VarunAPatil/sra-board-hardware-design/datasheets/README.md

# 2027 board datasheets

| Part | Local document | Publisher/reference |
| --- | --- | --- |
| TPS54202 | [TPS54202.pdf](TPS54202.pdf) | [Texas Instruments](https://www.ti.com/lit/ds/symlink/tps54202.pdf) |
| SS14 | [SS14.pdf](SS14.pdf) | Schottky diode datasheet |
| SS34 | [SS34.pdf](SS34.pdf) | Schottky diode datasheet |
| SS54 | [SS54.pdf](SS54.pdf) | SS54 through SS520 family datasheet |
| MAX7219 | Online: [MAX7219/MAX7221 datasheet](https://www.analog.com/media/en/technical-documentation/data-sheets/MAX7219-MAX7221.pdf) | Analog Devices |
| SPDT slide switch | [SPDT-slide-switch.pdf](SPDT-slide-switch.pdf) | [Sunrom document 460](https://www.sunrom.com/download/460.pdf), as requested |
| MPU-6050 | Online: [MPU-6000/MPU-6050 product specification](https://product.tdk.com/system/files/dam/doc/product/sensor/mortion-inertial/imu/data_sheet/mpu-6000-datasheet1.pdf) | TDK InvenSense |
| ESP32-S3-WROOM-1 | [ESP32-S3-WROOM-1.pdf](ESP32-S3-WROOM-1.pdf) | Espressif |
| AMS1117-3.3 | [AMS1117-3.3.pdf](AMS1117-3.3.pdf) | AMS1117 family |
| TB6612FNG | [TB6612FNG.pdf](TB6612FNG.pdf) | Toshiba |
| TCRT5000 | [TCRT5000.pdf](TCRT5000.pdf) | Vishay |
| AO3401A | [AO3401A.pdf](AO3401A.pdf) | AOSMD |
