VarunAPatil/sra-board-hardware-design/gerbers/README.md

# 2027 fabrication exports

| Board | ZIP | Uncompressed plots |
| --- | --- | --- |
| SRA controller | [sra_board_2027.zip](sra_board_2027.zip) | [sra_board_2027/](sra_board_2027/) |
| Line sensor array | [lsa_board_2027.zip](lsa_board_2027.zip) | [lsa_board_2027/](lsa_board_2027/) |
