VarunAPatil/sra-board-hardware-design/documentation/assets/led_matrix_schematic_detail.png

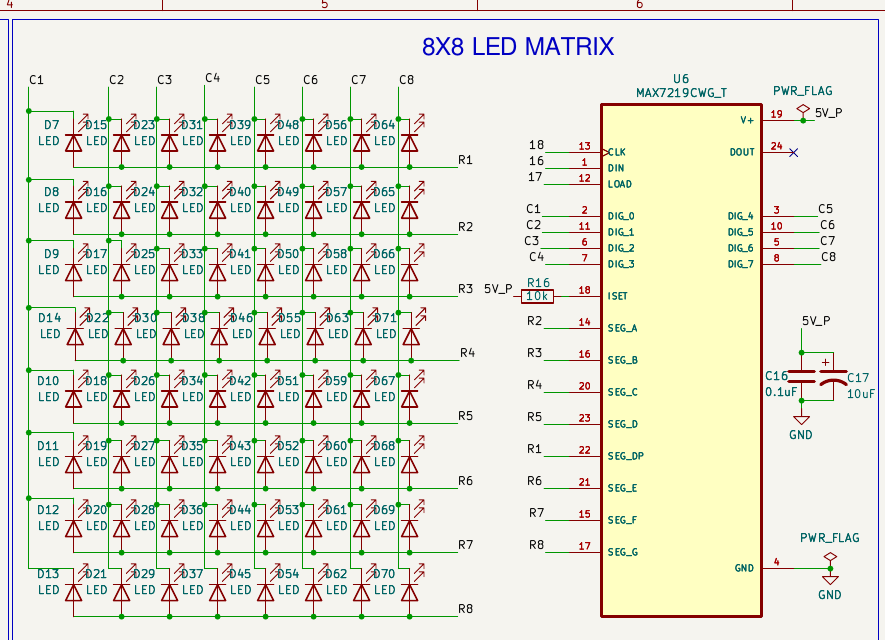
documentation/assets/led_matrix_schematic_detail.png
