VarunAPatil/sra-board-hardware-design/documentation/assets/lsa_interface_schematic_detail.png

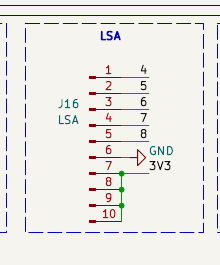
documentation/assets/lsa_interface_schematic_detail.png
