VarunAPatil/sra-board-hardware-design/documentation/assets/lsa_schematic_2027.png

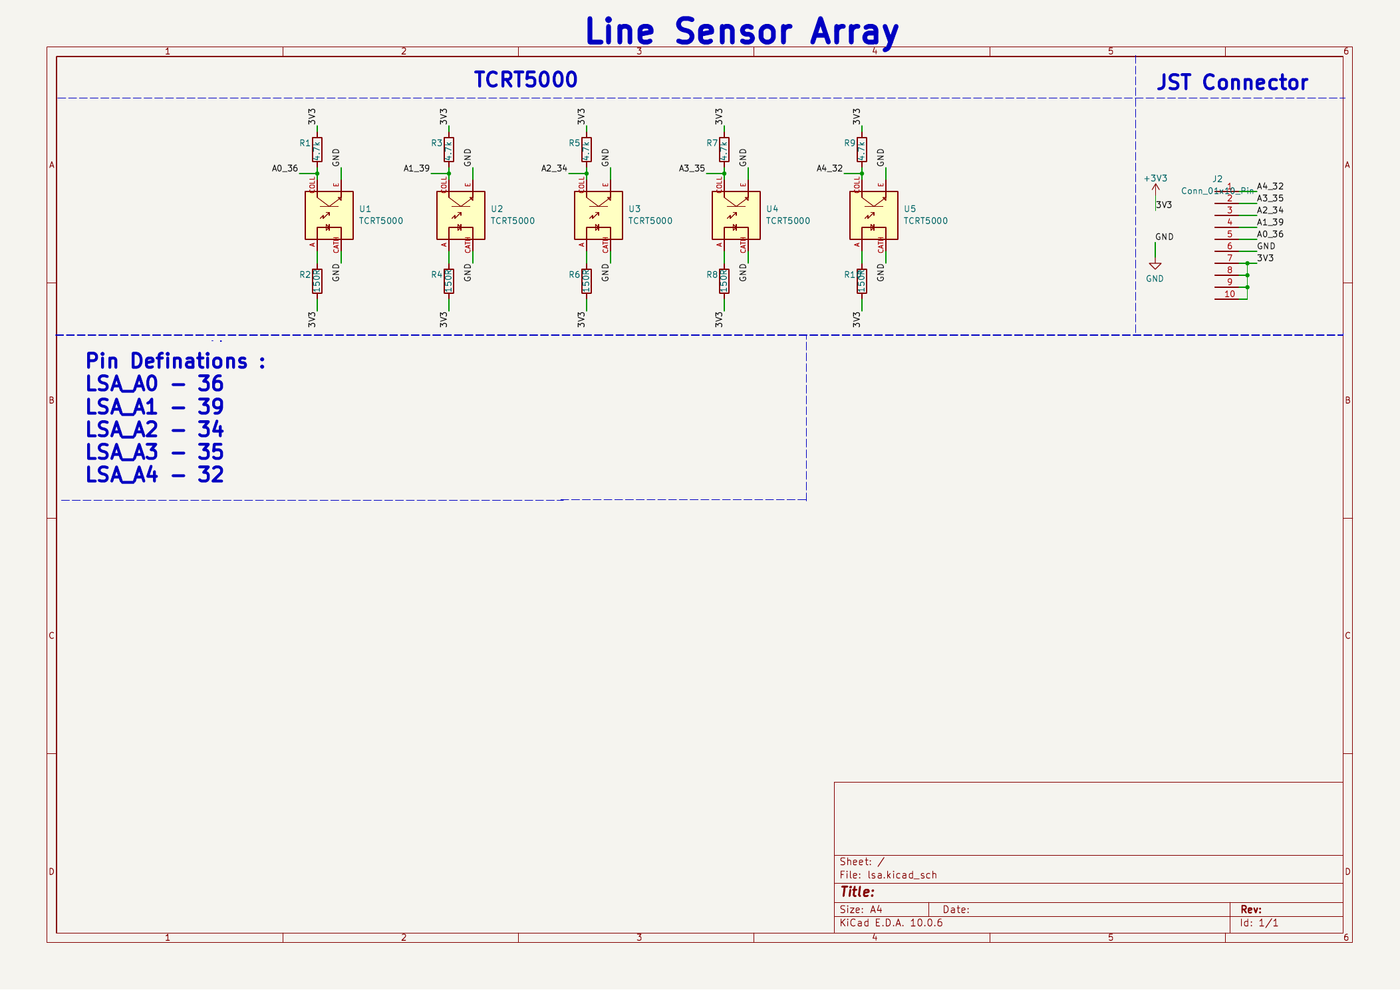
documentation/assets/lsa_schematic_2027.png
