VarunAPatil/sra-board-hardware-design/documentation/assets/motor_driver_schematic_detail.png

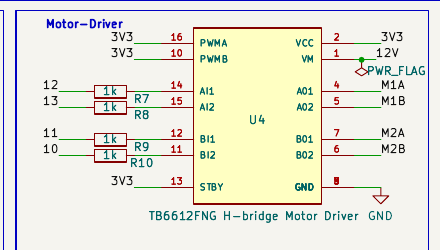
documentation/assets/motor_driver_schematic_detail.png
