VarunAPatil/sra-board-hardware-design/documentation/assets/mpu6050_schematic_detail.png

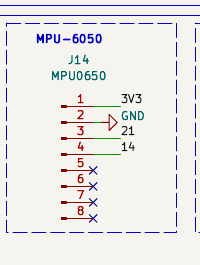
documentation/assets/mpu6050_schematic_detail.png
