VarunAPatil/sra-board-hardware-design/documentation/assets/oled_connector_schematic_detail.png

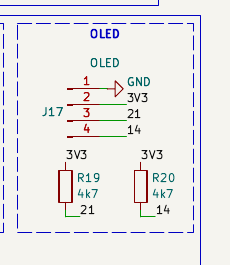
documentation/assets/oled_connector_schematic_detail.png
