VarunAPatil/sra-board-hardware-design/documentation/assets/power_stage_schematic_detail.png

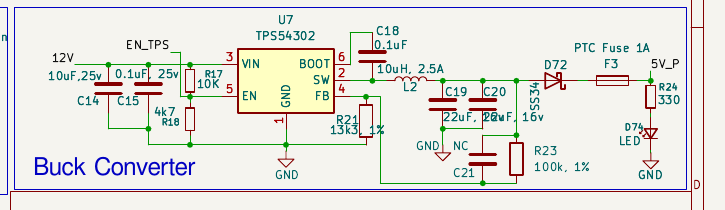
documentation/assets/power_stage_schematic_detail.png
