VarunAPatil/sra-board-hardware-design/documentation/assets/usb_c_schematic_detail.png

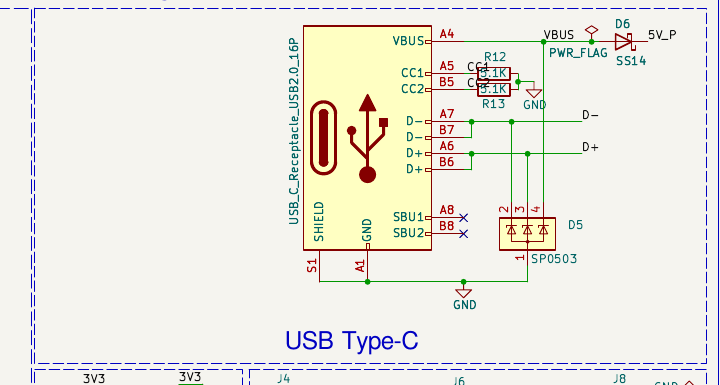
documentation/assets/usb_c_schematic_detail.png
