VarunAPatil/sra-board-hardware-design/lsa_board_2027/bom/lsa_board_2027.csv

Refs | Value | Footprint | Qty | DNP
J2 | Conn_01x10_Pin | Connector_FFC-FPC:JUSHUO_AFA07-S10FCA-00_1x10-1MP_P1.0mm_Horizontal | 1
R1 | 4.7k | Resistor_SMD:R_1206_3216Metric_Pad1.30x1.75mm_HandSolder | 1
R2 | 150R | Resistor_SMD:R_1206_3216Metric_Pad1.30x1.75mm_HandSolder | 1
R3 | 4.7k | Resistor_SMD:R_1206_3216Metric_Pad1.30x1.75mm_HandSolder | 1
R4 | 150R | Resistor_SMD:R_1206_3216Metric_Pad1.30x1.75mm_HandSolder | 1
R5 | 4.7k | Resistor_SMD:R_1206_3216Metric_Pad1.30x1.75mm_HandSolder | 1
R6 | 150R | Resistor_SMD:R_1206_3216Metric_Pad1.30x1.75mm_HandSolder | 1
R7 | 4.7k | Resistor_SMD:R_1206_3216Metric_Pad1.30x1.75mm_HandSolder | 1
R8 | 150R | Resistor_SMD:R_1206_3216Metric_Pad1.30x1.75mm_HandSolder | 1
R9 | 4.7k | Resistor_SMD:R_1206_3216Metric_Pad1.30x1.75mm_HandSolder | 1
R10 | 150R | Resistor_SMD:R_1206_3216Metric_Pad1.30x1.75mm_HandSolder | 1
U1 | TCRT5000 | TCRT5000:OPTO_TCRT5000 | 1
U2 | TCRT5000 | TCRT5000:OPTO_TCRT5000 | 1
U3 | TCRT5000 | TCRT5000:OPTO_TCRT5000 | 1
U4 | TCRT5000 | TCRT5000:OPTO_TCRT5000 | 1
U5 | TCRT5000 | TCRT5000:OPTO_TCRT5000 | 1
