VarunAPatil/sra-board-hardware-design/sra_board_2027/bom/sra_board_2027.csv

Refs | Value | Footprint | Qty | DNP
C5 | 0.1uF | Capacitor_SMD:C_0805_2012Metric | 1
C6 | 0.1uF | Capacitor_SMD:C_0805_2012Metric | 1
C7 | 0.1uF | Capacitor_SMD:C_0805_2012Metric | 1
C8 | 0.1uF | Capacitor_SMD:C_1206_3216Metric | 1
C9 | 0.1uF | Capacitor_SMD:C_1206_3216Metric | 1
C10 | 0.1uF, 16v | Capacitor_SMD:C_0805_2012Metric | 1
C11 | 10uF, 16v | Capacitor_SMD:C_0805_2012Metric | 1
C12 | 0.1uF | Capacitor_SMD:C_0805_2012Metric | 1
C13 | 22uF | Capacitor_SMD:C_0805_2012Metric | 1
C14 | 10uF,25v | Capacitor_SMD:C_1206_3216Metric | 1
C15 | 0.1uF, 25v | Capacitor_SMD:C_1206_3216Metric | 1
C16 | 0.1uF | Capacitor_SMD:C_0805_2012Metric | 1
C17 | 10uF | Capacitor_SMD:C_0805_2012Metric | 1
C18 | 0.1uF | Capacitor_SMD:C_0805_2012Metric | 1
C19 | 22uF, 16v | Capacitor_SMD:C_1206_3216Metric | 1
C20 | 22uF, 16v | Capacitor_SMD:C_1206_3216Metric | 1
C22 | 10uF | Capacitor_SMD:C_0805_2012Metric | 1
D5 | SP0503 | Package_TO_SOT_SMD:SOT-143 | 1
D6 | SS14 | Diode_SMD:D_SMA | 1
D7 | LED | LED_SMD:LED_0805_2012Metric | 1
D8 | LED | LED_SMD:LED_0805_2012Metric | 1
D9 | LED | LED_SMD:LED_0805_2012Metric | 1
D10 | LED | LED_SMD:LED_0805_2012Metric | 1
D11 | LED | LED_SMD:LED_0805_2012Metric | 1
D12 | LED | LED_SMD:LED_0805_2012Metric | 1
D13 | LED | LED_SMD:LED_0805_2012Metric | 1
D14 | LED | LED_SMD:LED_0805_2012Metric | 1
D15 | LED | LED_SMD:LED_0805_2012Metric | 1
D16 | LED | LED_SMD:LED_0805_2012Metric | 1
D17 | LED | LED_SMD:LED_0805_2012Metric | 1
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
Q7 | ZXMP4A16GTA | Package_TO_SOT_SMD:SOT-223 | 1
R1 | 33k | Resistor_SMD:R_0805_2012Metric | 1
R2 | 10k | Resistor_SMD:R_0805_2012Metric | 1
R7 | 1k | Resistor_SMD:R_0805_2012Metric | 1
R8 | 1k | Resistor_SMD:R_0805_2012Metric | 1
R9 | 1k | Resistor_SMD:R_0805_2012Metric | 1
R10 | 1k | Resistor_SMD:R_0805_2012Metric | 1
R11 | 10K | Resistor_SMD:R_0805_2012Metric | 1
R12 | 5.1K | Resistor_SMD:R_0805_2012Metric | 1
R13 | 5.1K | Resistor_SMD:R_0805_2012Metric | 1
R14 | 100K | Resistor_SMD:R_0805_2012Metric | 1
R15 | 330 | Resistor_SMD:R_0805_2012Metric | 1
R16 | 10k | Resistor_SMD:R_0805_2012Metric | 1
R17 | 10K | Resistor_SMD:R_0805_2012Metric | 1
R18 | 4k7 | Resistor_SMD:R_0805_2012Metric | 1
R19 | 4k7 | Resistor_SMD:R_0805_2012Metric | 1
R20 | 4k7 | Resistor_SMD:R_0805_2012Metric | 1
R21 | 13k3, 1% | Resistor_SMD:R_0805_2012Metric | 1
R22 | 10K | Resistor_SMD:R_0805_2012Metric | 1
R23 | 100k, 1% | Resistor_SMD:R_0805_2012Metric | 1
R24 | 330 | Resistor_SMD:R_0805_2012Metric | 1
R25 | 330 | Resistor_SMD:R_0805_2012Metric | 1
SW1 | SW_0 | Button_Switch_SMD:SW_Push_SPST_NO_Alps_SKRK | 1
SW2 | SW_EN | Button_Switch_SMD:SW_Push_SPST_NO_Alps_SKRK | 1
SW3 | SMD Slide switch | Button_Switch_SMD:SW_SPDT_Shouhan_MSK12C02 | 1
SW4 | SMD Slide switch | Button_Switch_SMD:SW_SPDT_Shouhan_MSK12C02 | 1
TP1 | TestPoint_2Pole | footprints:test_point | 1
TP2 | TestPoint | footprints:test_point | 1
TP3 | TestPoint | footprints:test_point | 1
TP5 | TestPoint | footprints:test_point | 1
U2 | ESP32-S3-WROOM-1 | RF_Module:ESP32-S3-WROOM-1 | 1
U4 | TB6612FNG H-bridge Motor Driver | footprints:MODULE_ROB-14450 | 1
U5 | AMS1117-3.3 | Package_TO_SOT_SMD:SOT-223-3_TabPin2 | 1
U6 | MAX7219CWG_T | footprints:SOIC24 | 1
U7 | TPS54302 | Package_TO_SOT_SMD:SOT-23-6 | 1
