VarunAPatil/sra-board-hardware-design/3d_models/components/MPU6050Module.step

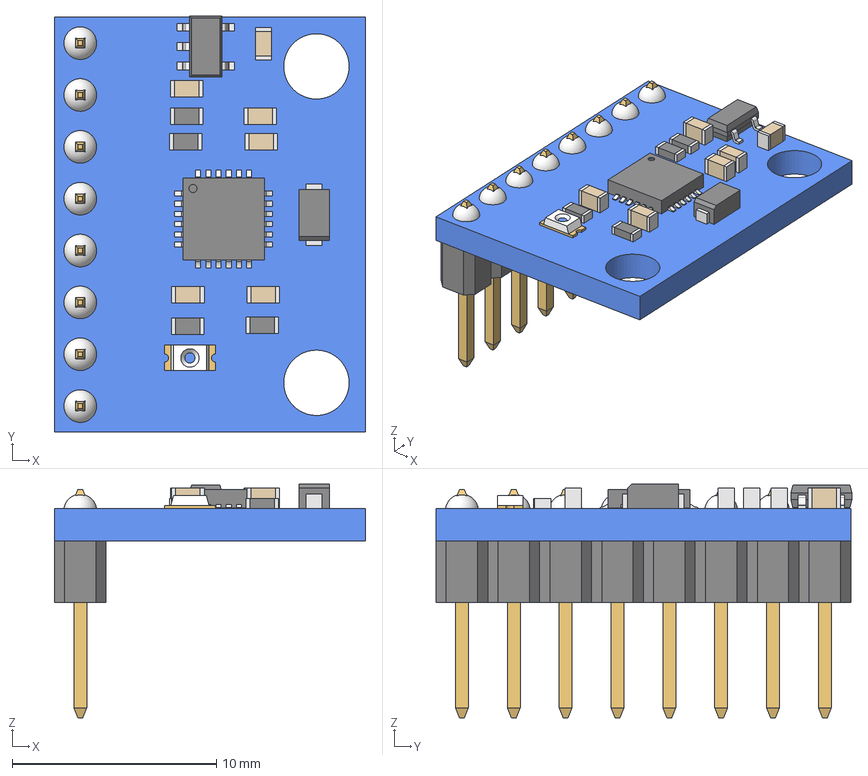
[picture p14: CAD file, 2026-11-04]
3d_models/components/MPU6050Module.step
15.3 x 20.4 x 11.5 mm
Board_001
SOT25_001
0603 Capacitor_001
0603 Capacitor_002
0603 Capacitor_003
0603 Capacitor_004
0603 Capacitor_005
0603 Capacitor_006
0603 Resistor_001
0603 Resistor_002
0603 Resistor_003
0603 Resistor_004
SM LED_001
Diode 2_001
24 QFN_001
1x8 Male Header_001
