VarunAPatil/sra-board-hardware-design/3d_models/sra_board_2027.step

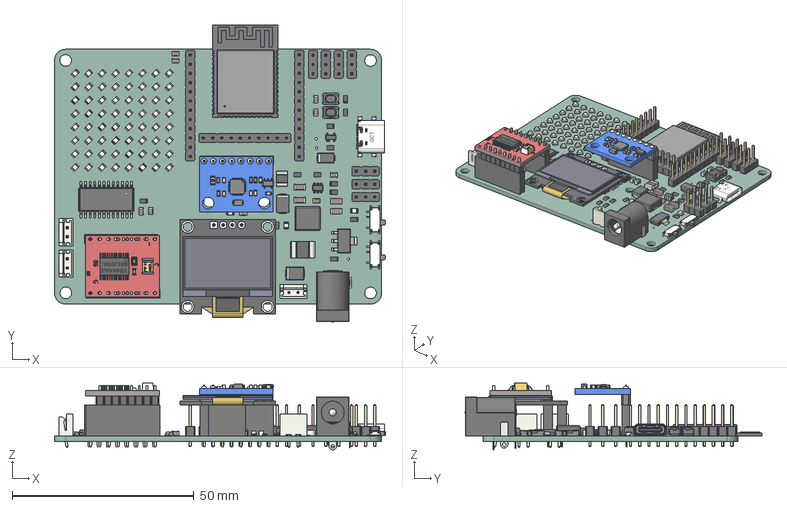
[picture p15: CAD file, 2026-11-04]
3d_models/sra_board_2027.step
91.1 x 81.7 x 18.4 mm
C_0805_2012Metric x 12
USB4110-GF-A_revB(1) MF
R_0805_2012Metric x 21
LED_0805_2012Metric x 67
PinHeader_1x03_P254mm_Vertical x 7
JST_B2B_EH_A x 3
8x1 male header pins v2 x 2
PinSocket_1x08_P2.54mm_Vertical x 3
ESP32-S3-WROOM-1
C_1206_3216Metric x 6
Board_001
SOT25_001
0603 Capacitor_001
0603 Capacitor_002
0603 Capacitor_003
0603 Capacitor_004
0603 Capacitor_005
0603 Capacitor_006
0603 Resistor_001
0603 Resistor_002
0603 Resistor_003
0603 Resistor_004
SM LED_001
Diode 2_001
24 QFN_001
1x8 Male Header_001
D_SMA
SOT-23-6
PinHeader_1x12_P254mm_Vertical x 2
MSK12C02 x 2
SOT-223 x 2
Fuse_1210_3225Metric x 2
a71ba5e0-8551-11ed-a139-00155d22e2d7_part
a71ba716-8551-11ed-a139-00155d22e2d7_part
a71ba78e-8551-11ed-a139-00155d22e2d7_part
D_SMB x 2
PinSocket_1x04_P2.54mm_Vertical
Body - PCB
Body - Back Panel
Body - Adhesive Pad
Body - Front Panel
Body - Flex Connector Bend
Body - Flex Connector Terminals
Body - Black Tape
Body - Protective Foil
Body - Screen Border
Extrude - Annular Rings
SW_SPST_PTS810 x 2
HTSSOP-24-1EP_4.4x7.8mm_P0.65mm_EP3.4x7.8mm_Mask2.4x4.68mm
PinHeader_1x10_P254mm_Vertical
SOT-143
BarrelJack_Horizontal
sra_board_PCB
