VarunAPatil/sra-board-hardware-design/3d_models/components/TCRT5000.step

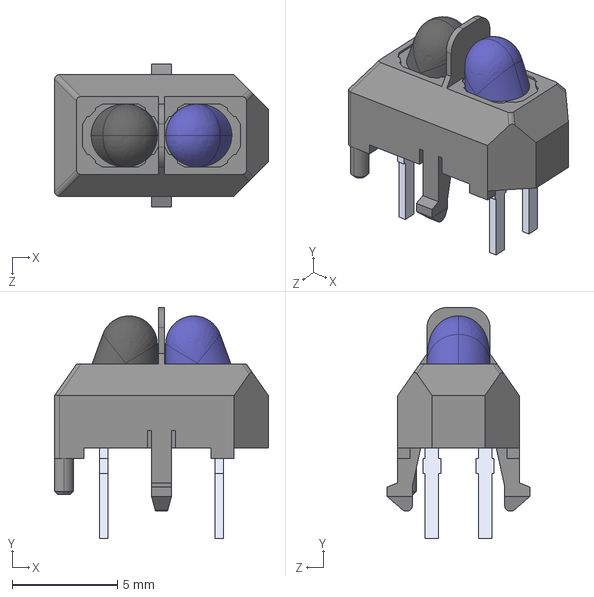
[picture p16: CAD file, 2026-11-04]
3d_models/components/TCRT5000.step
10.2 x 11.0 x 6.80 mm
