VarunAPatil/sra-board-hardware-design/3d_models/lsa_board_2027.step

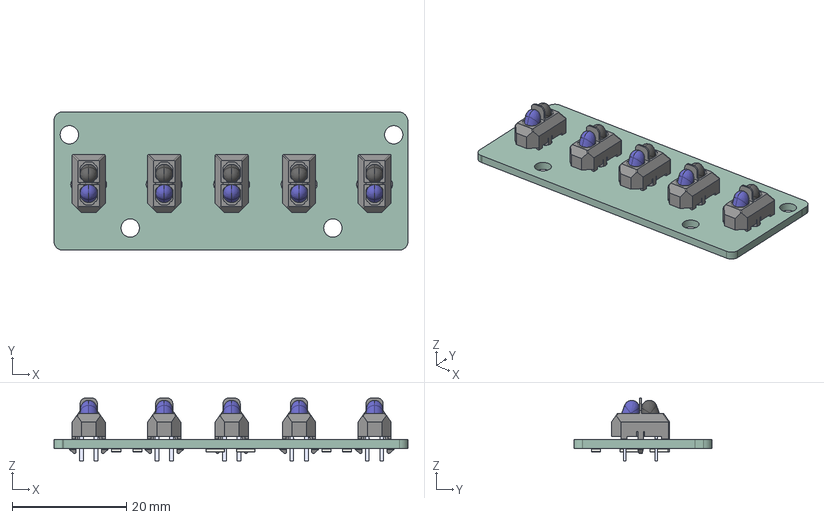
[picture p17: CAD file, 2026-11-04]
3d_models/lsa_board_2027.step
61.9 x 24.2 x 11.0 mm
TCRT5000 x 5
R_1206_3216Metric x 10
lsa_PCB
