VarunAPatil/sra-board-hardware-design/3d_models/components/MotorDriver.step

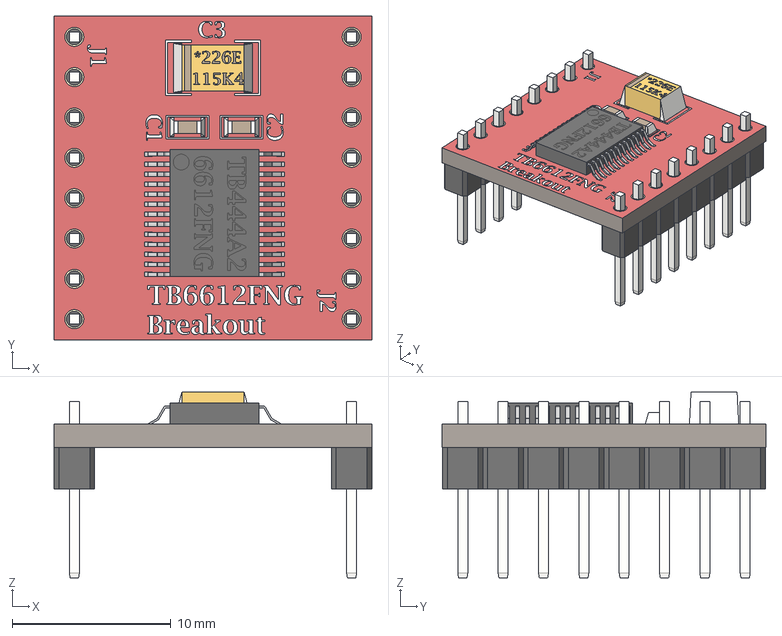
[picture p18: CAD file, 2026-11-04]
3d_models/components/MotorDriver.step
20.0 x 20.4 x 11.7 mm
8x1 male header pins x 2
