VarunAPatil/sra-board-hardware-design/3d_models/components/spdt-switch.stp

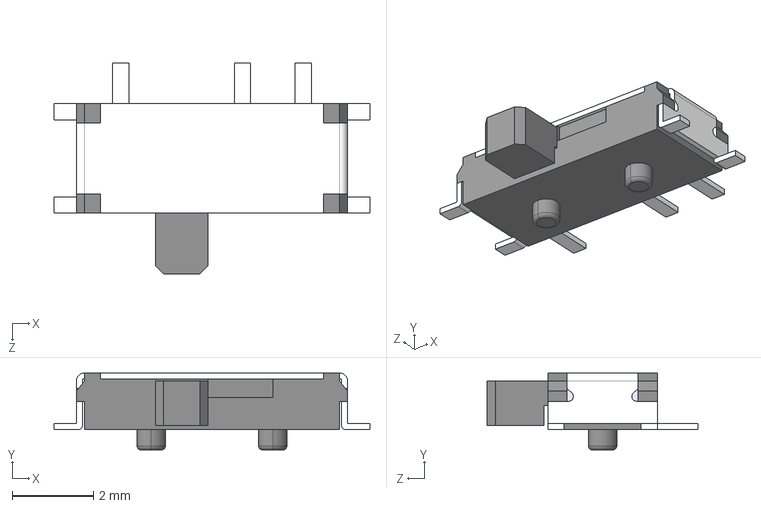
[picture p19: CAD file, 2026-11-04]
3d_models/components/spdt-switch.stp
7.80 x 1.90 x 5.20 mm
