VarunAPatil/sra-board-hardware-design/3d_models/components/MAX7219.step

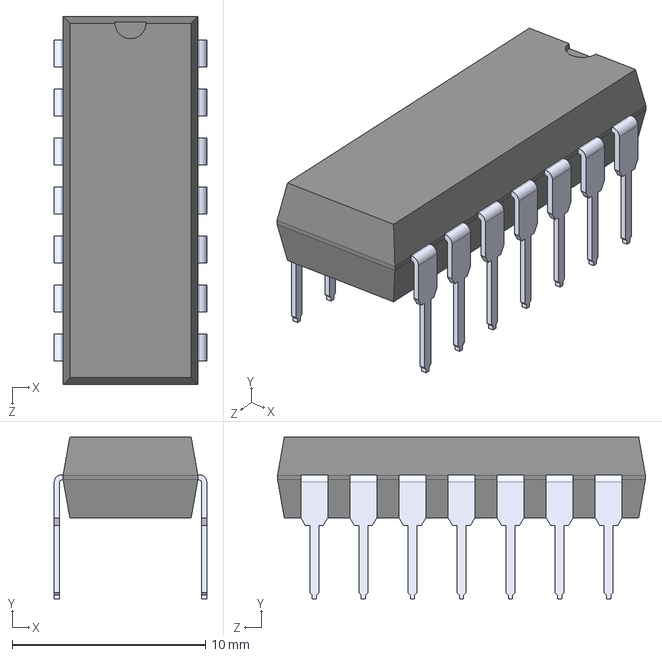
[picture p20: CAD file, 2026-11-04]
3d_models/components/MAX7219.step
7.90 x 8.38 x 19.1 mm
