VarunAPatil/sra-board-hardware-design/3d_models/components/USB4110.STEP

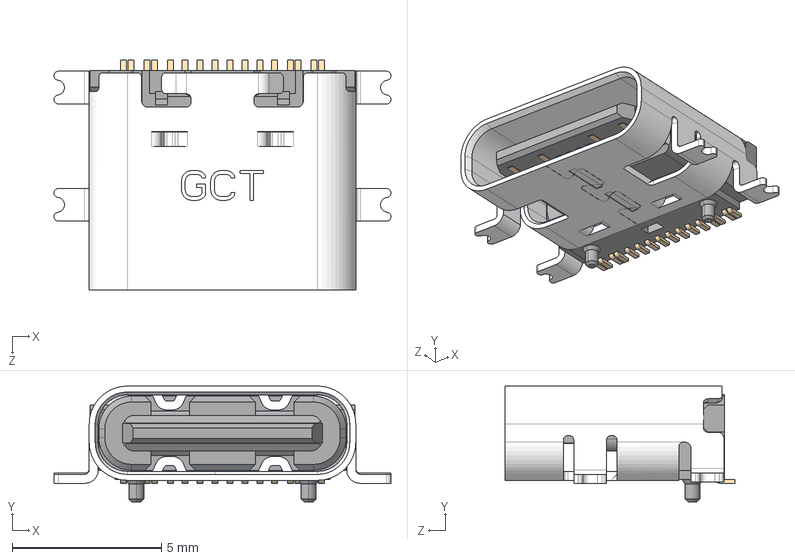
[picture p21: CAD file, 2026-11-04]
3d_models/components/USB4110.STEP
11.3 x 3.89 x 7.70 mm
