VarunAPatil/sra-board-hardware-design/3d_models/components/OLED.step

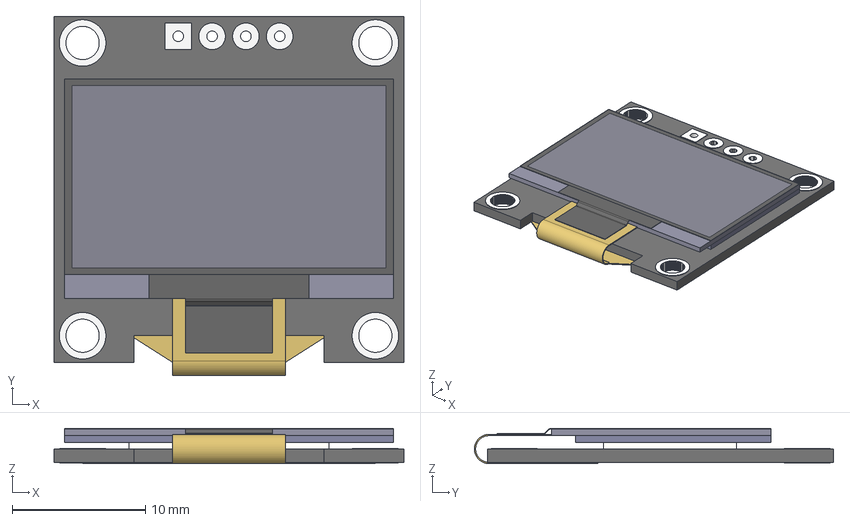
[picture p22: CAD file, 2026-11-04]
3d_models/components/OLED.step
26.3 x 27.0 x 2.65 mm
Body - PCB
Body - Back Panel
Body - Adhesive Pad
Body - Front Panel
Body - Flex Connector Bend
Body - Flex Connector Terminals
Body - Black Tape
Body - Protective Foil
Body - Screen Border
Extrude - Annular Rings
