VarunAPatil/sra-board-hardware-design/sra_board_2027/sra_board.kicad_pcb

## KiCad design sra_board_2027/sra_board.kicad_pcb (2026-11-04)

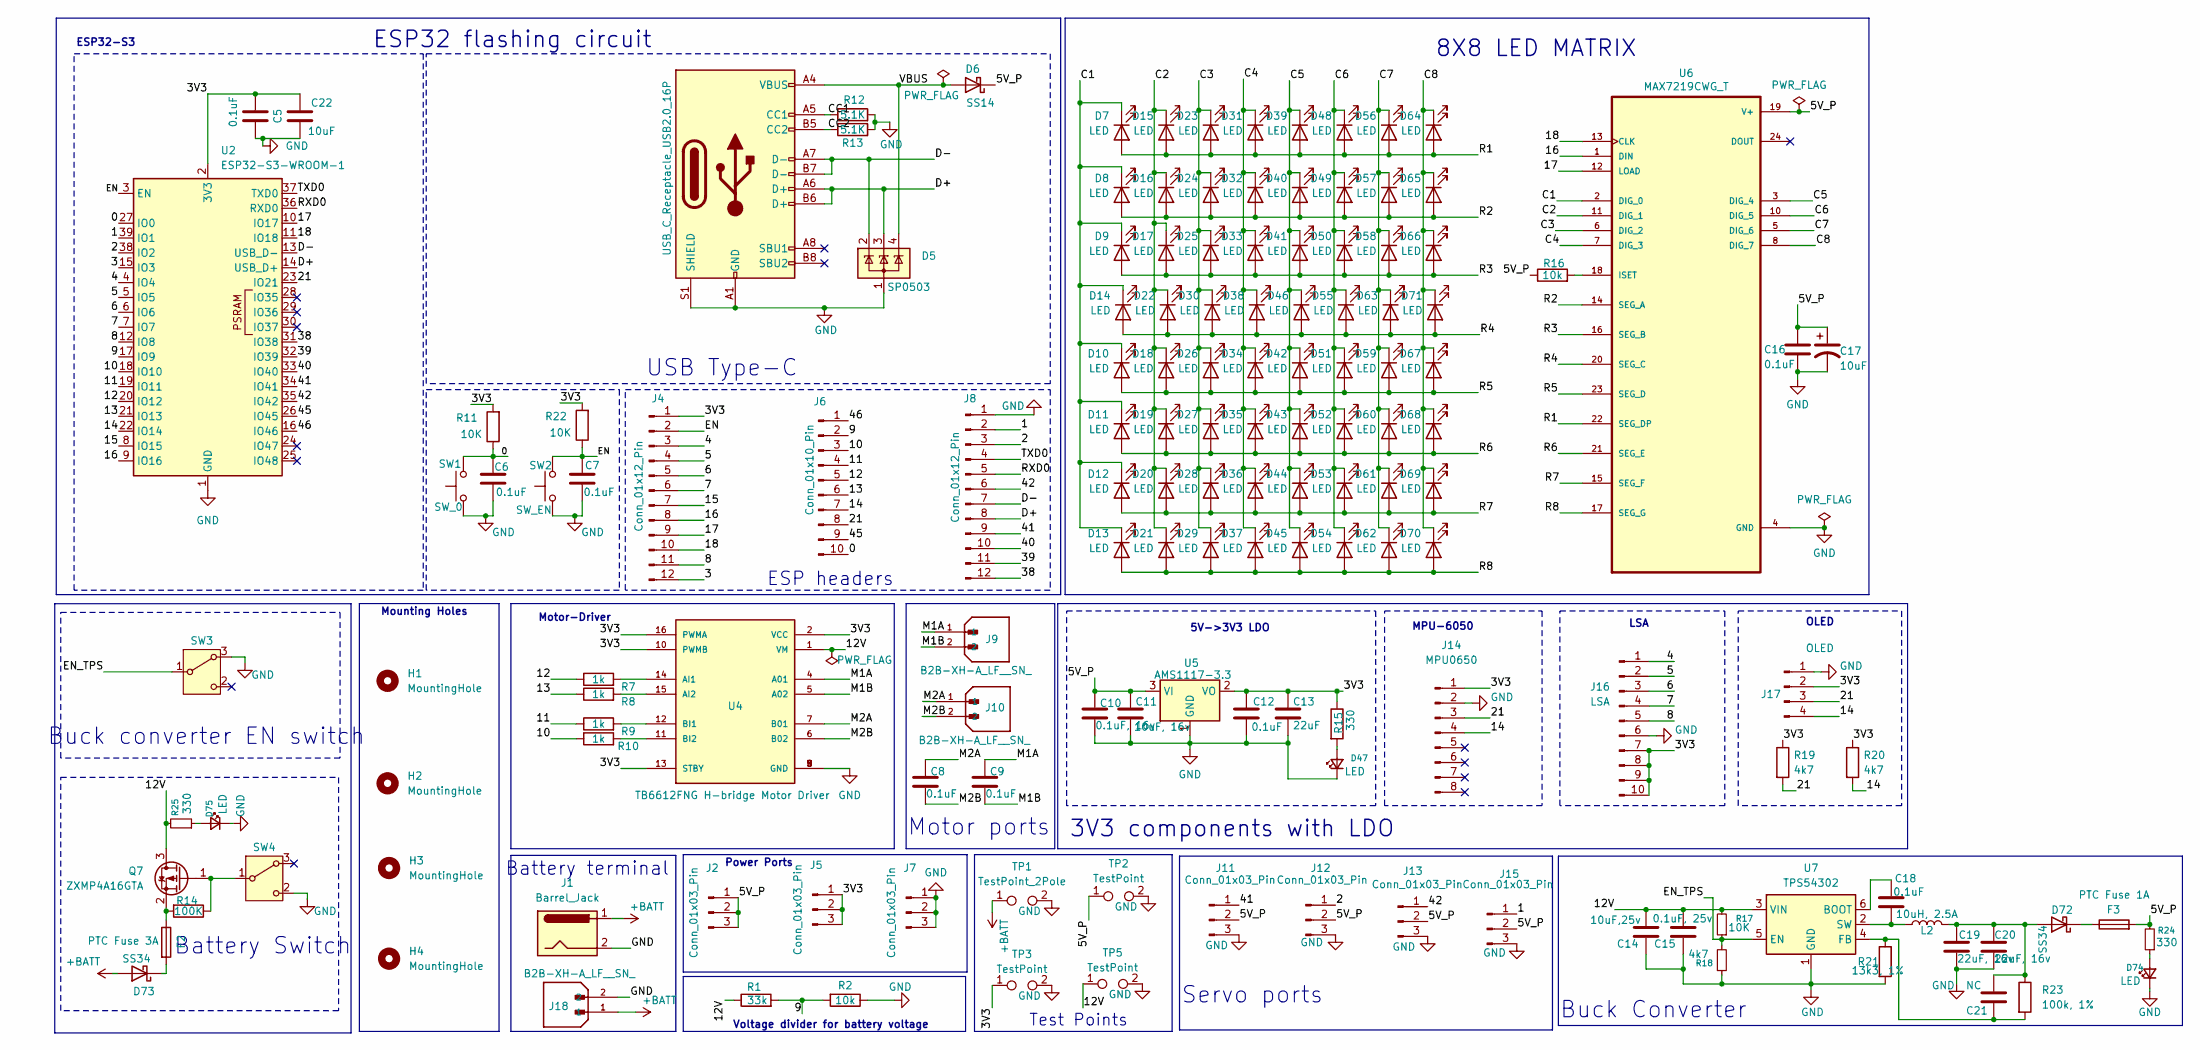
[picture p23: schematic sra_board.kicad_sch, SRA BOARD 2026-27]

Parts:
C5, C6, C7, C12, C16, C18: 0.1uF; C_0805_2012Metric
C8, C9: 0.1uF; C_1206_3216Metric
C10: 0.1uF, 16v; C_0805_2012Metric
C11: 10uF, 16v; C_0805_2012Metric
C13: 22uF; C_0805_2012Metric
C14: 10uF,25v; C_1206_3216Metric
C15: 0.1uF, 25v; C_1206_3216Metric
C17, C22: 10uF; C_0805_2012Metric
C19, C20: 22uF, 16v; C_1206_3216Metric
C21: NC; C_0805_2012Metric
D5: SP0503; SOT-143
D6: SS14; D_SMA
D7, D8, D9, D10, D11, D12, D13, D14, D15, D16, D17, D18, D19, D20, D21, D22, D23, D24, D25, D26, D27, D28, D29, D30, D31, D32, D33, D34, D35, D36, D37, D38, D39, D40, D41, D42, D43, D44, D45, D46, D47, D48, D49, D50, D51, D52, D53, D54, D55, D56, D57, D58, D59, D60, D61, D62, D63, D64, D65, D66, D67, D68, D69, D70, D71, D74, D75: LED; LED_0805_2012Metric
D72, D73: SS34; D_SMB
F2: PTC Fuse 3A; Fuse_2920_7451Metric
F3: PTC Fuse 1A; Fuse_1812_4532Metric
H1, H2, H3, H4: MountingHole; MountingHole_3.2mm_M3_DIN965_Pad_TopOnly
J1: Barrel_Jack; BarrelJack_Wuerth_6941xx301002
J2, J5, J7, J11, J12, J13, J15: Conn_01x03_Pin; PinHeader_1x03_P2.54mm_Vertical
J3: USB_C_Receptacle_USB2.0_16P; USB_C_Receptacle_GCT_USB4110
J4, J8: Conn_01x12_Pin; PinHeader_1x12_P2.54mm_Vertical
J6: Conn_01x10_Pin; PinHeader_1x10_P2.54mm_Vertical
J9, J10, J18: B2B-XH-A_LF__SN_; JST_EH_B2B-EH-A_1x02_P2.50mm_Vertical; PARTREV N/A
J14: MPU0650; PinSocket_1x08_P2.54mm_Vertical
J16: LSA; JUSHUO_AFA07-S10FCA-00_1x10-1MP_P1.0mm_Horizontal
J17: OLED; PinSocket_1x04_P2.54mm_Vertical
L2: 10uH, 2.5A; L_Sunlord_MWSA0603S
Q7: ZXMP4A16GTA; SOT-223
R1: 33k; R_0805_2012Metric
R2, R16: 10k; R_0805_2012Metric
R7, R8, R9, R10: 1k; R_0805_2012Metric
R11, R17, R22: 10K; R_0805_2012Metric
R12, R13: 5.1K; R_0805_2012Metric
R14: 100K; R_0805_2012Metric
R15, R24, R25: 330; R_0805_2012Metric
R18, R19, R20: 4k7; R_0805_2012Metric
R21: 13k3, 1%; R_0805_2012Metric
R23: 100k, 1%; R_0805_2012Metric
SW1: SW_0; SW_Push_SPST_NO_Alps_SKRK
SW2: SW_EN; SW_Push_SPST_NO_Alps_SKRK
SW3, SW4: SMD Slide switch; SW_SPDT_Shouhan_MSK12C02
TP1: TestPoint_2Pole; test_point
TP2, TP3, TP5: TestPoint; test_point
U2: ESP32-S3-WROOM-1
U4: TB6612FNG H-bridge Motor Driver; MODULE_ROB-14450
U5: AMS1117-3.3; SOT-223-3_TabPin2
U6: MAX7219CWG_T; SOIC24
U7: TPS54302; SOT-23-6

Connections:
+BATT: D73.2 (A), J1.1, J18.1, TP1.1 (1_1)
/0: C6.2, J6.10, R11.1, SW1.2, U2.27 (IO0)
/1: J8.2, J15.1, U2.39 (IO1)
/2: J8.3, J12.1, U2.38 (IO2)
/3: J4.12, U2.15 (IO3)
/3V3: C5.2, C12.1, C13.1, C22.1, J4.1, J5.1, J5.2, J5.3, J14.1, J16.7, J16.8, J16.9, J16.10, J17.2, R11.2, R15.1, R19.1, R20.1, R22.2, TP3.1 (1_1), U2.2 (3V3), U4.2 (VCC), U4.10 (PWMB), U4.13 (STBY), U4.16 (PWMA), U5.2 (VO)
/4: J4.3, J16.1, U2.4 (IO4)
/5: J4.4, J16.2, U2.5 (IO5)
/5V_P: C10.1, C11.1, C16.1, C17.1, D6.1 (K), F3.2, J2.1, J2.2, J2.3, J11.2, J12.2, J13.2, J15.2, R16.1, R24.2, TP2.1 (1_1), U5.3 (VI), U6.19 (V+)
/6: J4.5, J16.3, U2.6 (IO6)
/7: J4.6, J16.4, U2.7 (IO7)
/8: J4.11, J16.5, U2.12 (IO8)
/9: J6.2, R1.2, R2.2, U2.17 (IO9); also elsewhere on the board
/10: J6.3, R10.1, U2.18 (IO10)
/11: J6.4, R9.1, U2.19 (IO11)
/12: J6.5, R7.1, U2.20 (IO12)
/12V: C14.1, C15.1, Q7.3 (D), R1.1, R17.2, R25.2, TP5.1 (1_1), U4.1 (VM), U7.3 (VIN); also elsewhere on the board
/13: J6.6, R8.1, U2.21 (IO13)
/14: J6.7, J14.4, J17.4, R20.2, U2.22 (IO14)
/15: J4.7, U2.8 (IO15)
/16: J4.8, U2.9 (IO16), U6.1 (DIN)
/17: J4.9, U2.10 (IO17), U6.12 (LOAD)
/18: J4.10, U2.11 (IO18), U6.13 (CLK)
/21: J6.8, J14.3, J17.3, R19.2, U2.23 (IO21)
/38: J8.12, U2.31 (IO38)
/39: J8.11, U2.32 (IO39)
/40: J8.10, U2.33 (IO40)
/41: J8.9, J11.1, U2.34 (IO41)
/42: J8.6, J13.1, U2.35 (IO42)
/45: J6.9, U2.26 (IO45)
/46: J6.1, U2.16 (IO46)
/C1: D7.1 (K), D8.1 (K), D9.1 (K), D10.1 (K), D11.1 (K), D12.1 (K), D13.1 (K), D14.1 (K), U6.2 (DIG_0)
/C2: D15.1 (K), D16.1 (K), D17.1 (K), D18.1 (K), D19.1 (K), D20.1 (K), D21.1 (K), D22.1 (K), U6.11 (DIG_1)
/C3: D23.1 (K), D24.1 (K), D25.1 (K), D26.1 (K), D27.1 (K), D28.1 (K), D29.1 (K), D30.1 (K), U6.6 (DIG_2)
/C4: D31.1 (K), D32.1 (K), D33.1 (K), D34.1 (K), D35.1 (K), D36.1 (K), D37.1 (K), D38.1 (K), U6.7 (DIG_3)
/C5: D39.1 (K), D40.1 (K), D41.1 (K), D42.1 (K), D43.1 (K), D44.1 (K), D45.1 (K), D46.1 (K), U6.3 (DIG_4)
/C6: D48.1 (K), D49.1 (K), D50.1 (K), D51.1 (K), D52.1 (K), D53.1 (K), D54.1 (K), D55.1 (K), U6.10 (DIG_5)
/C7: D56.1 (K), D57.1 (K), D58.1 (K), D59.1 (K), D60.1 (K), D61.1 (K), D62.1 (K), D63.1 (K), U6.5 (DIG_6)
/C8: D64.1 (K), D65.1 (K), D66.1 (K), D67.1 (K), D68.1 (K), D69.1 (K), D70.1 (K), D71.1 (K), U6.8 (DIG_7)
/CC1: J3.A5 (CC1), R12.1; also elsewhere on the board
/CC2: J3.B5 (CC2), R13.1; also elsewhere on the board
/D+: D5.3 (K), J3.A6 (D+), J3.B6 (D+), J8.8, U2.14 (USB_D+); also elsewhere on the board
/D-: D5.2 (K), J3.A7 (D-), J3.B7 (D-), J8.7, U2.13 (USB_D-); also elsewhere on the board
/EN: C7.2, J4.2, R22.1, SW2.2, U2.3 (EN)
/EN_TPS: R17.1, R18.2, SW3.1 (B), U7.5 (EN)
/M1A: C9.1, J9.1, U4.4 (A01)
/M1B: C9.2, J9.2, U4.5 (A02)
/M2A: C8.1, J10.1, U4.7 (B01)
/M2B: C8.2, J10.2, U4.6 (B02)
/R1: D7.2 (A), D15.2 (A), D23.2 (A), D31.2 (A), D39.2 (A), D48.2 (A), D56.2 (A), D64.2 (A), U6.22 (SEG_DP)
/R2: D8.2 (A), D16.2 (A), D24.2 (A), D32.2 (A), D40.2 (A), D49.2 (A), D57.2 (A), D65.2 (A), U6.14 (SEG_A)
/R3: D9.2 (A), D17.2 (A), D25.2 (A), D33.2 (A), D41.2 (A), D50.2 (A), D58.2 (A), D66.2 (A), U6.16 (SEG_B)
/R4: D14.2 (A), D22.2 (A), D30.2 (A), D38.2 (A), D46.2 (A), D55.2 (A), D63.2 (A), D71.2 (A), U6.20 (SEG_C)
/R5: D10.2 (A), D18.2 (A), D26.2 (A), D34.2 (A), D42.2 (A), D51.2 (A), D59.2 (A), D67.2 (A), U6.23 (SEG_D)
/R6: D11.2 (A), D19.2 (A), D27.2 (A), D35.2 (A), D43.2 (A), D52.2 (A), D60.2 (A), D68.2 (A), U6.21 (SEG_E)
/R7: D12.2 (A), D20.2 (A), D28.2 (A), D36.2 (A), D44.2 (A), D53.2 (A), D61.2 (A), D69.2 (A), U6.15 (SEG_F)
/R8: D13.2 (A), D21.2 (A), D29.2 (A), D37.2 (A), D45.2 (A), D54.2 (A), D62.2 (A), D70.2 (A), U6.17 (SEG_G)
/RXD0: J8.5, U2.36 (RXD0)
/TXD0: J8.4, U2.37 (TXD0)
/VBUS: D5.4 (K), D6.2 (A), J3.A4 (VBUS), J3.A9 (VBUS), J3.B4 (VBUS), J3.B9 (VBUS); also elsewhere on the board
GND: C5.1, C6.1, C7.1, C10.2, C11.2, C12.2, C13.2, C14.2, C15.2, C16.2, C17.2, C19.2, C20.2, C22.2, D5.1 (A), D47.1 (K), D74.1 (K), D75.1 (K), J1.2, J3.A1 (GND), J3.A12 (GND), J3.B1 (GND), J3.B12 (GND), J3.S1 (SHIELD), J7.1, J7.2, J7.3, J8.1, J11.3, J12.3, J13.3, J14.2, J15.3, J16.6, J17.1, J18.2, R2.1, R12.2, R13.2, R18.1, R21.2, SW1.1 (1_1), SW2.1, SW3.3 (A), SW4.2 (C), TP1.2, TP2.2, TP3.2, TP5.2, U2.1 (GND), U2.40 (GND), U2.41 (GND), U4.3 (GND), U4.8 (GND), U4.9 (GND), U5.1 (GND), U6.4 (GND), U6.9 (GND), U7.1 (GND); also elsewhere on the board
unnamed: D47.2 (A), R15.2
unnamed: C19.1, C20.1, C21.1, D72.2 (A), L2.2, R23.1
unnamed: D72.1 (K), F3.1
unnamed: D73.1 (K), F2.2
unnamed: D74.2 (A), R24.1
unnamed: D75.2 (A), R25.1
unnamed: Q7.1 (G), R14.1, SW4.1 (B)
unnamed: F2.1, Q7.2 (S), R14.2
unnamed: R7.2, U4.14 (AI1)
unnamed: R8.2, U4.15 (AI2)
unnamed: R9.2, U4.12 (BI1)
unnamed: R10.2, U4.11 (BI2)
unnamed: R16.2, U6.18 (ISET)
unnamed: C18.1, U7.6 (BOOT)
unnamed: C21.2, R21.1, R23.2, U7.4 (FB)
unnamed: C18.2, L2.1, U7.2 (SW)

Notes on the sheet:
ESP32 flashing circuit
Power Ports
Motor-Driver
5V->3V3 LDO
ESP32-S3
Mounting Holes
Buck Converter
8X8 LED MATRIX
ESP headers
MPU-6050
Battery terminal
Voltage divider for battery voltage
LSA
OLED
3V3 components with LDO
Test Points
Battery Switch
USB Type-C
Servo ports
Buck converter EN switch
Motor ports

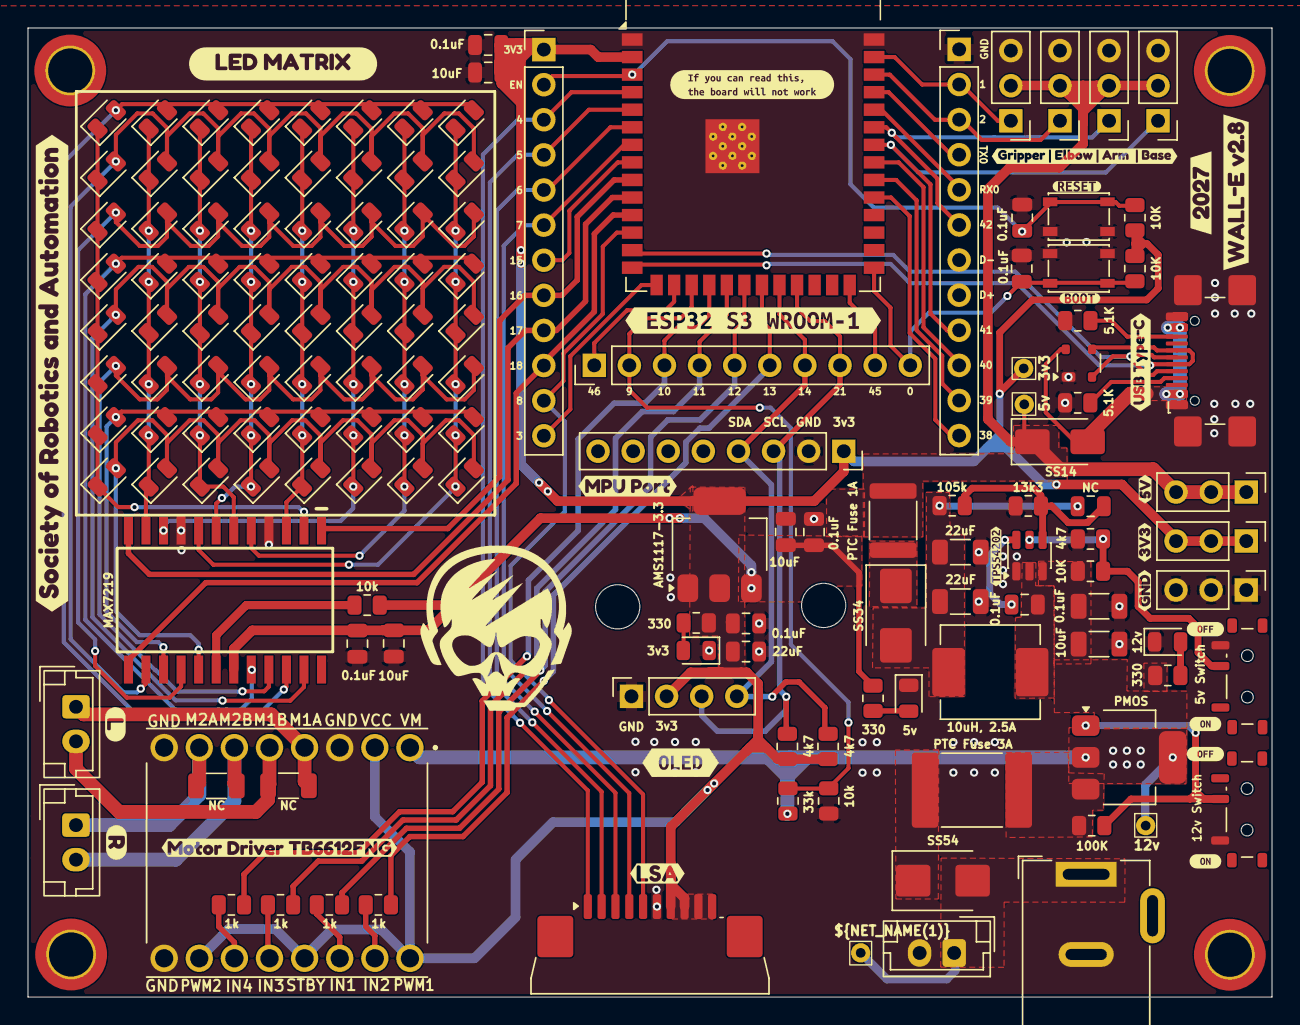
[picture p24: board sra_board.kicad_pcb from above]

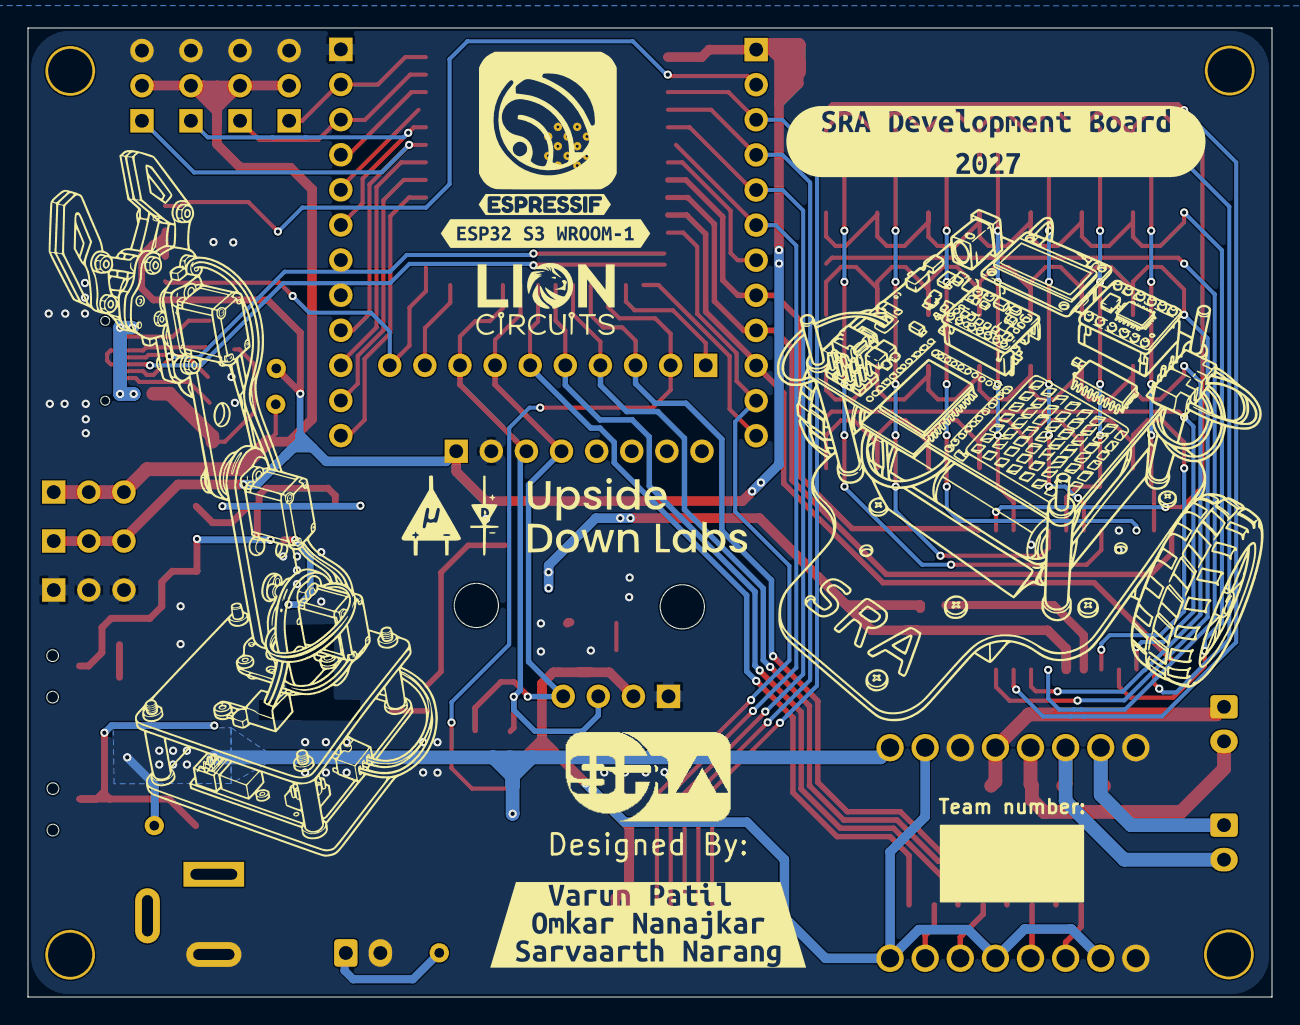
[picture p25: board sra_board.kicad_pcb from below]

Board: 2 copper layers, 90.0 x 70.1 mm, 179 parts (4 on the bottom side), 77 nets.

Other parts of the board:
10k: 10k; R_0805_2012Metric
33k3: 33k; R_0805_2012Metric
H5, H6: MountingHole; MountingHole_3.2mm_M3
J20: USB_C_Receptacle_USB2.0_16P; USB_C_Receptacle_GCT_USB4110
kibuzzard-6A8B3292: G***; kibuzzard-6A8B3292
kibuzzard-6A95D08E: G***; kibuzzard-6A95D08E
kibuzzard-6A955F10: G***; kibuzzard-6A955F10
kibuzzard-6A9563B5: G***; kibuzzard-6A9563B5
kibuzzard-6AB2B412, kibuzzard-6AB2B412#2: G***; kibuzzard-6AB2B412
kibuzzard-6AB2B440, kibuzzard-6AB2B440#2: G***; kibuzzard-6AB2B440
kibuzzard-6ABFEC95: G***; kibuzzard-6ABFEC95
kibuzzard-6ABFECB0: G***; kibuzzard-6ABFECB0
kibuzzard-6AC0B409: G***; kibuzzard-6AC0B409
kibuzzard-6AC3A33F: G***; kibuzzard-6AC3A33F
kibuzzard-6AC3A571: G***; kibuzzard-6AC3A571
kibuzzard-6AC39C0C: G***; kibuzzard-6AC39C0C
kibuzzard-6AC39C9E: G***; kibuzzard-6AC39C9E
kibuzzard-6AC39C35: G***; kibuzzard-6AC39C35
kibuzzard-6AC39D95: G***; kibuzzard-6AC39D95
kibuzzard-68E7F907: G***; kibuzzard-68E7F907
kibuzzard-658F2C3C: G***; kibuzzard-658F2C3C
kibuzzard-668D4F81: G***; kibuzzard-668D4F81
kibuzzard-668FE423: G***; kibuzzard-668FE423
kibuzzard-6774F4AA: G***; kibuzzard-6774F4AA
kibuzzard-6774F4AE: G***; kibuzzard-6774F4AE
kibuzzard-67704CCE: G***; kibuzzard-67704CCE
kibuzzard-67704CDF: G***; kibuzzard-67704CDF
kibuzzard-67704CF4: G***; kibuzzard-67704CF4
kibuzzard-66921043: G***; kibuzzard-66921043
kibuzzard-66923428: G***; kibuzzard-66923428

Their connections:
/9: 10k.2, 33k3.2; also elsewhere on the board
/12V: 33k3.1; also elsewhere on the board
/CC1: J20.A5 (CC1); also elsewhere on the board
/CC2: J20.B5 (CC2); also elsewhere on the board
/D+: J20.A6 (D+), J20.B6 (D+); also elsewhere on the board
/D-: J20.A7 (D-), J20.B7 (D-); also elsewhere on the board
/VBUS: J20.A4 (VBUS), J20.A9 (VBUS), J20.B4 (VBUS), J20.B9 (VBUS); also elsewhere on the board
GND: 10k.1, J20.A1 (GND), J20.A12 (GND), J20.B1 (GND), J20.B12 (GND), J20.S1 (SHIELD); also elsewhere on the board
