VarunAPatil/sra-board-hardware-design/lsa_board_2027/lsa.kicad_pcb

## KiCad design lsa_board_2027/lsa.kicad_pcb (2026-11-04)

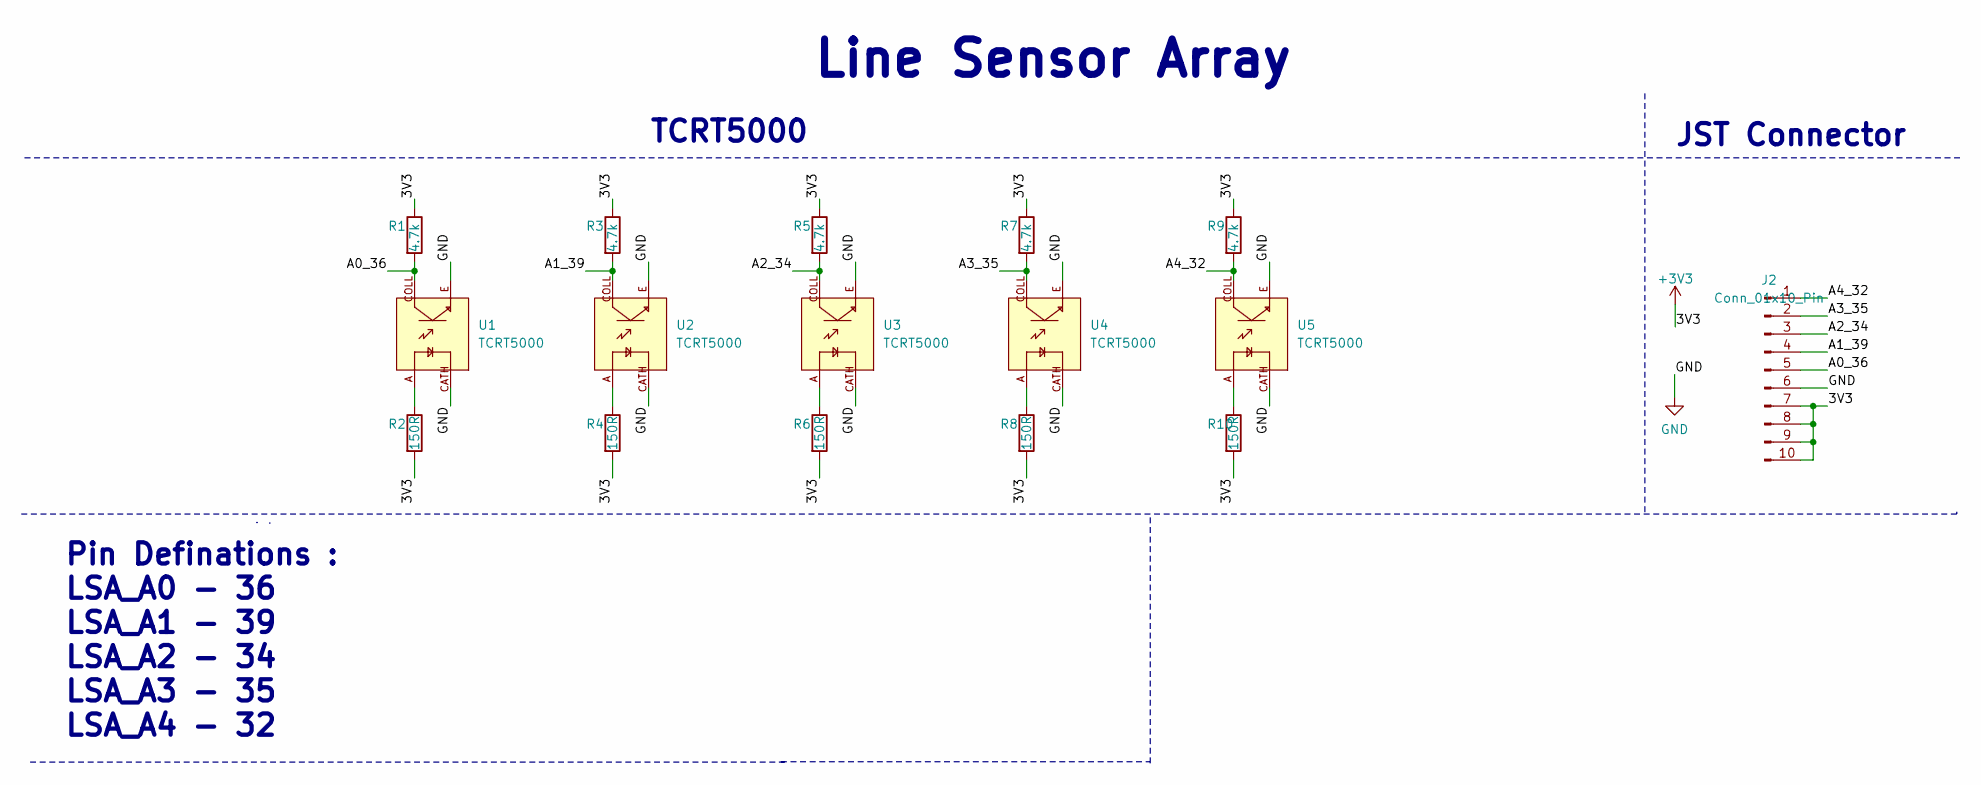
[picture p26: schematic lsa.kicad_sch]

Parts:
J2: Conn_01x10_Pin; JUSHUO_AFA07-S10FCA-00_1x10-1MP_P1.0mm_Horizontal
R1, R3, R5, R7, R9: 4.7k; R_1206_3216Metric_Pad1.30x1.75mm_HandSolder
R2, R4, R6, R8, R10: 150R; R_1206_3216Metric_Pad1.30x1.75mm_HandSolder
U1, U2, U3, U4, U5: TCRT5000; OPTO_TCRT5000; PARTREV 1.7

Connections:
+3V3: J2.7, J2.8, J2.9, J2.10, R1.1, R2.2, R3.1, R4.2, R5.1, R6.2, R7.1, R8.2, R9.1, R10.2
/A0_36: J2.5, R1.2, U1.COLL
/A1_39: J2.4, R3.2, U2.COLL
/A2_34: J2.3, R5.2, U3.COLL
/A3_35: J2.2, R7.2, U4.COLL
/A4_32: J2.1, R9.2, U5.COLL
GND: J2.6, J2.MP, U1.CATH, U1.E, U2.CATH, U2.E, U3.CATH, U3.E, U4.CATH, U4.E, U5.CATH, U5.E
unnamed: R2.1, U1.A
unnamed: R4.1, U2.A
unnamed: R6.1, U3.A
unnamed: R8.1, U4.A
unnamed: R10.1, U5.A

Notes on the sheet:
JST Connector
Line Sensor Array
TCRT5000
Pin Definations : LSA_A0 - 36 LSA_A1 - 39 LSA_A2 - 34 LSA_A3 - 35 LSA_A4 - 32

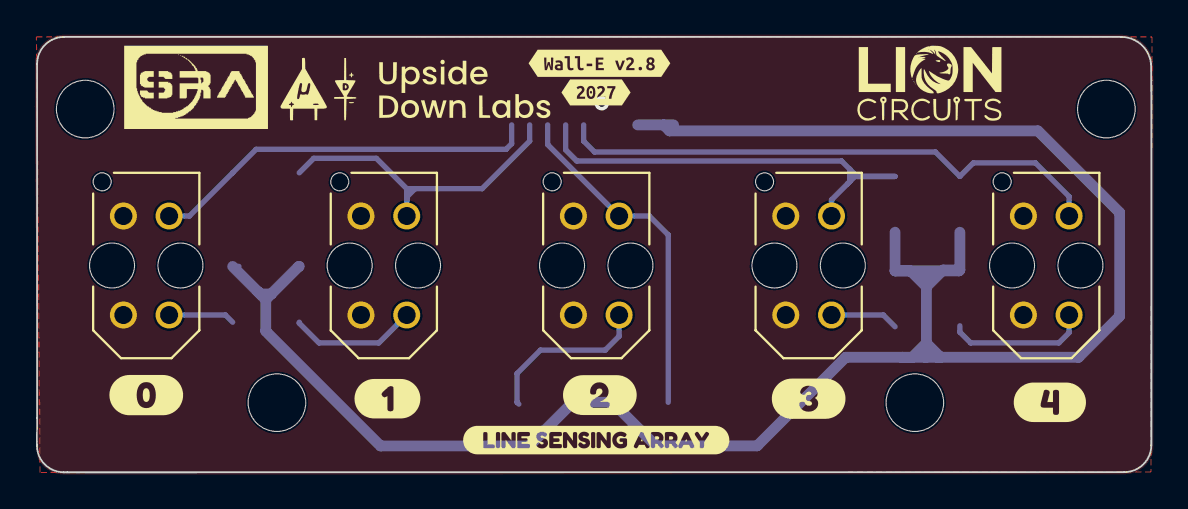
[picture p27: board lsa.kicad_pcb from above]

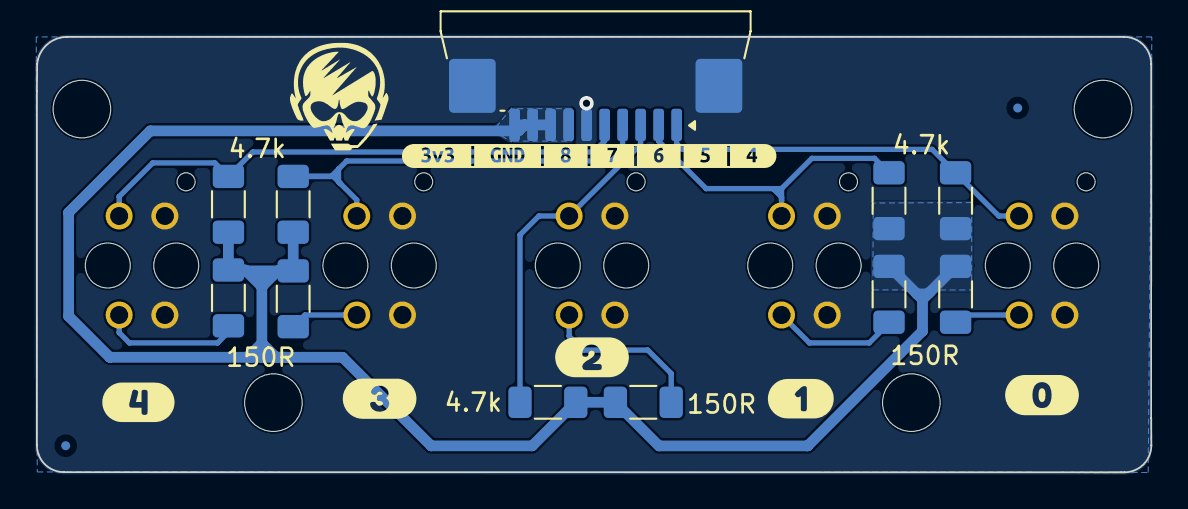
[picture p28: board lsa.kicad_pcb from below]

Board: 2 copper layers, 61.9 x 24.2 mm, 30 parts (17 on the bottom side), 12 nets.

Other parts of the board:
kibuzzard-6A70DDC1: G***; kibuzzard-6A70DDC1
kibuzzard-6A70DDE3: G***; kibuzzard-6A70DDE3
kibuzzard-6AC3C74E: G***; kibuzzard-6AC3C74E
kibuzzard-672CF9E4: G***; kibuzzard-672CF9E4
kibuzzard-63708D58, kibuzzard-63708D58#2: G***; kibuzzard-63708D58
kibuzzard-63708D75, kibuzzard-63708D75#2: G***; kibuzzard-63708D75
kibuzzard-63708D85, kibuzzard-63708D85#2: G***; kibuzzard-63708D85
kibuzzard-63708DAF, kibuzzard-63708DAF#2: G***; kibuzzard-63708DAF
kibuzzard-63708DBF, kibuzzard-63708DBF#2: G***; kibuzzard-63708DBF
